manzyun/ErgoDash/Doc/Shoplist_JP.md

# ErgoDashの買い物リスト[国内]

Cherry MX 互換 スイッチ × 66～70  
https://yushakobo.jp/product-category/switches/  
https://talpkeyboard.stores.jp/?category_id=59cf8860ed05e668db003f5d  

Keycap × 66～70 (基本的に1uのみで構成可、配列によって2uに変更)  
https://talpkeyboard.stores.jp/?category_id=59be183f428f2d49120007b1  
https://talpkeyboard.stores.jp/?category_id=59e2acfaed05e644fd004008  

1N4148 ダイオード × 66～70  
http://akizukidenshi.com/catalog/g/gI-00743/  
https://talpkeyboard.stores.jp/items/59eadbffc8f22c15de001638  

Pro Micro × 2  
https://www.switch-science.com/catalog/1623/  
https://yushakobo.jp/shop/promicro-spring-pinheader/  
https://talpkeyboard.stores.jp/items/5b24504ba6e6ee7ec60063e3

TRRS jack MJ-4PP-9 × 2  
http://akizukidenshi.com/catalog/g/gC-06070/

MJTP1117 switch × 2  
https://www.marutsu.co.jp/pc/i/13351221/  
https://www.digikey.jp/product-detail/ja/apem-inc/MJTP1117/679-2400-ND/1795496  

TRRS cable × 1 (RGB Underglowを使用する場合4極が必要)  
https://www.sengoku.co.jp/mod/sgk_cart/detail.php?code=EEHD-4Z7Y  
https://www.sengoku.co.jp/mod/sgk_cart/detail.php?code=EEHD-4Z84  
https://www.sengoku.co.jp/mod/sgk_cart/detail.php?code=EEHD-4Z87  

Micro USB cable × 1  

M2×5mm ねじ × 22  

M2×8mm ねじ × 6  

M2×6mm スペーサー × 14  
http://www.hirosugi-net.co.jp/shop/c/c10141010/

ゴム足 × 8  

------Option------  
スプリングピンヘッダ12P × 4 ([Helix](https://github.com/MakotoKurauchi/helix)で使用されているものです。)  
https://yushakobo.jp/shop/a01mc-00/  

---Backlight---  
LED 3mm × 66～70  
例(実機未確認)
https://akizukidenshi.com/catalog/c/ctbn3mm/

https://www.aitendo.com/product/10043
(BOXスイッチの場合)

470Ω resistor × 66～70  
http://akizukidenshi.com/catalog/g/gR-16471/  
1kΩ resistor × 2  
http://akizukidenshi.com/catalog/g/gR-16102/  
NchMOSFET IRLML6344TRPbF × 2  
http://akizukidenshi.com/catalog/g/gI-06049/  

---RGB Underglow---  
LED WS2812B × 24  
http://akizukidenshi.com/catalog/g/gI-07915/

又は  
LEDテープ × 2
