manzyun/ErgoDash/(list of files, cad)

Other CAD files:
Keycaps/Keycaps_rev3.FCStd
Keycaps/Keycaps_rev3.stl
