manzyun/ErgoDash/(commit log)

2020-09-22 [Add] キーマップの追加
2020-10-18 [WIP] サイズの変更
2020-10-18 [Mod] テンプレートも更新。
2020-10-18 [Mod] 自分が制作したファイルの変更
    ただし、A4 から 300x450 にキャンバスサイズが大きくなる。
2021-10-03 [Comp] zeroType32Custom and Paphis Prototype
2021-10-14 [Add] Make order for mod materials.
2022-05-30 [Add] Keycap model source.
    [keycap.scad]
2022-05-31 [Add] Keycap modules.
    [keycap.scad]
2022-07-12 [Add] Many contents...
    * Add `*.ai`
    * Add Firmware(or: keymap) *.json
    * Add *.scad s code.
    [keycap.scad]
2022-07-18 [Fix] Clear Warnings of undefind variables
    [keycap.scad]
2022-07-18 [Buggy] 2x1 keycap assembly
    * ALL stems is NOT intersected
    * 2x1 keycap is NOT attach stems
    * One 2x1 keycap is LOST workspace
    [keycap.scad]
2022-09-16 [Buggy][Add] stl files and FreeCAD modify files.
    I have this commit is foolish.
    [keycap.scad, keycaps-cylinder_face-vertical_2_size.FCStd, keycaps-cylinder_face-vertical_2_size.stl, keycaps-cylinder_face.FCStd, keycaps-cylinder_face.stl, keycaps-sphire_face-neutral_finger_marked.FCStd, keycaps-sphire_face-neutral_finger_marked.stl, keycaps-sphire_face.FCStd]
2023-06-12 [Add] How to use QMK CLI and ready.
    [pyvenv.cfg]
2026-02-21 [Mod] Keycap data.
    [Keycaps_rev3.FCStd, Keycaps_rev3.stl, keycaps-cylinder_face-vertical_2_size.FCStd, keycaps-cylinder_face-vertical_2_size.stl, keycaps-cylinder_face.FCStd, keycaps-cylinder_face.stl, keycaps-sphire_face-neutral_finger_marked.FCStd, keycaps-sphire_face-neutral_finger_marked.stl]
